highno/wordclock_mini/docs/wordclock mini_breadboard.png

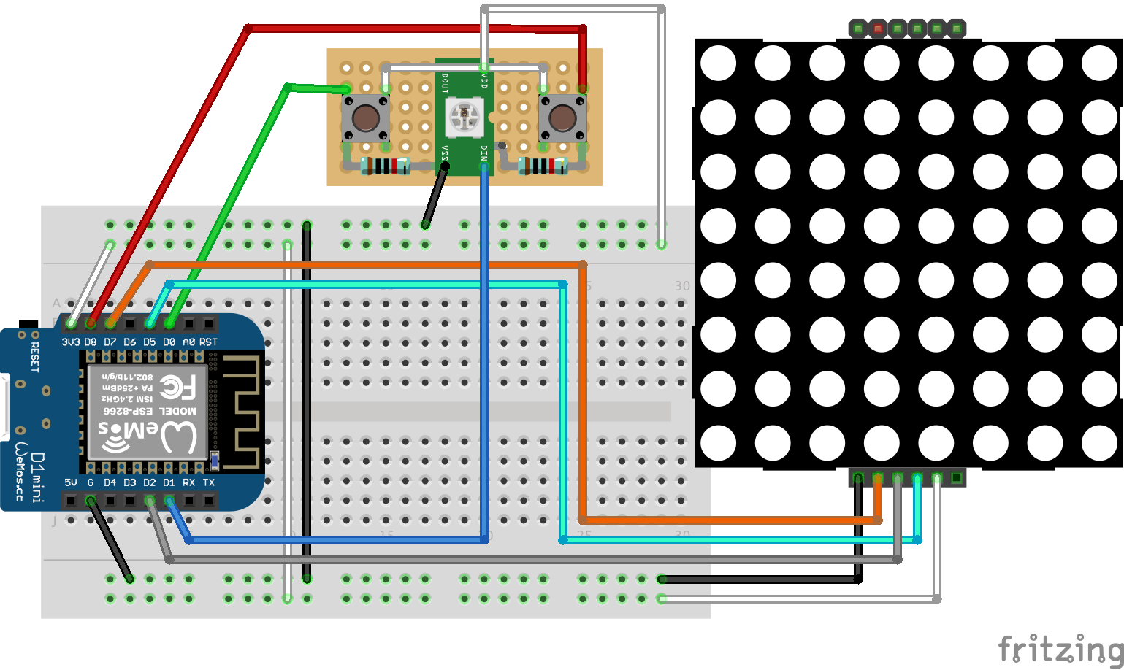
docs/wordclock mini_breadboard.png
