highno/wordclock_mini/docs/wordclock mini_schematics.png

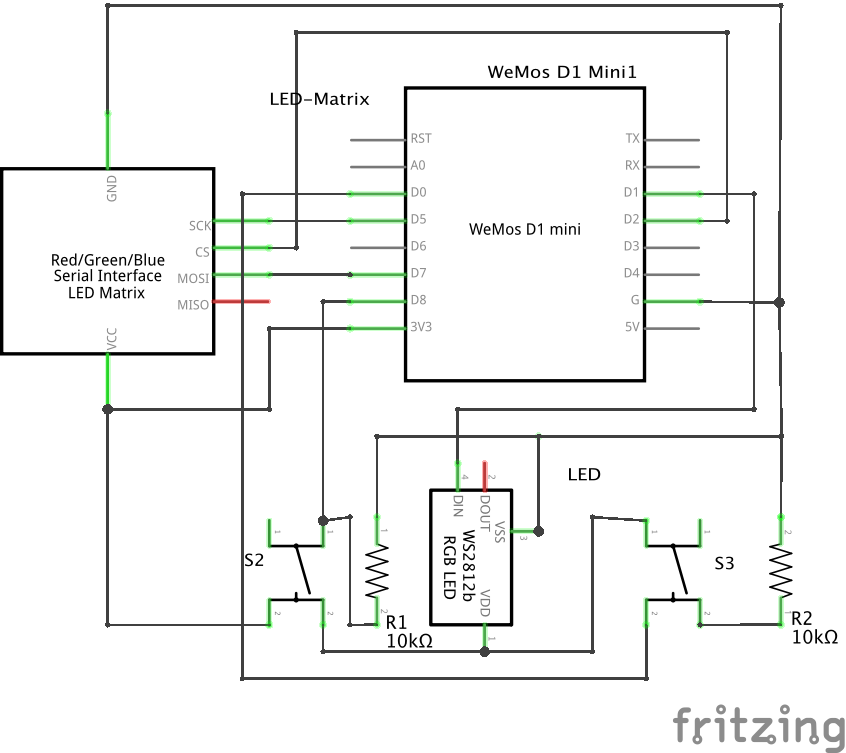
docs/wordclock mini_schematics.png
