highno/wordclock_mini/include/cp437font.h

#include <Arduino.h>
// bit patterns for the CP437 font

const byte cp437_fontsize [] PROGMEM = {
  0x08,
  0x08,
  0x08,
  0x07,
  0x07,
  0x07,
  0x07,
  0x24,
  0x08,
  0x16,
 
  0x08,
  0x08,
  0x16,
  0x08,
  0x08,
  0x08,
  0x07,
  0x07,
  0x16,
  0x16,
  
  0x08,
  0x08,
  0x16,
  0x08,
  0x16,
  0x16,
  0x07,
  0x07,
  0x07,
  0x08,
  
  0x08,
  0x08,
  0x05,
  0x14,
  0x23,
  0x07,
  0x06,
  0x07,
  0x07,
  0x03,
  
  0x14,
  0x14,
  0x08,
  0x06,
  0x13,
  0x04,
  0x22,
  0x07,
  0x07,
  0x06,
  
  0x06,
  0x06,
  0x07,
  0x06,
  0x06,
  0x06,
  0x06,
  0x06,
  0x22,
  0x13,
  
  0x05,
  0x04,
  0x15,
  0x06,
  0x07,
  0x16, // A
  0x16,
  0x16,
  0x16,
  0x16,

  0x16, // F
  0x16,
  0x16,
  0x24,
  0x16,
  0x16,
  0x16, // L
  0x17,
  0x17,
  0x16,
  
  0x16,
  0x16, // Q
  0x16,
  0x16,
  0x16,
  0x16, // U
  0x16,
  0x17,
  0x17,
  0x16,
  
  0x16, // Z
  0x14,
  0x07,
  0x14,
  0x07,
  0x05,
  0x23,
  0x16, // a
  0x16,
  0x16,
  
  0x16,
  0x16, // e
  0x16,
  0x16,
  0x16,
  0x32,
  0x15, // j
  0x16,
  0x33,
  
  0x17,
  0x16,
  0x16, // o
  0x16,
  0x16,
  0x16,
  0x16,
  0x25, // t
  0x16,
  0x16,
  
  0x17,
  0x16,
  0x16, // y
  0x16,
  
  0x06,
  0x32,
  0x06,
  0x07,
  0x07,
  
  0x06, // 0x80
  0x07,
  0x06,
  0x08,
  0x07,
  
  0x07,
  0x07,
  0x06,
  0x08,
  0x06,
  
  0x06,
  0x06,
  0x07,
  0x05,
  0x07,
  
  0x06, // 0x8f
  0x06,
  0x08,
  0x07,
  0x06,
  
  0x06,
  0x06,
  0x07,
  0x07,
  0x06,
  
  0x08,
  0x06,
  0x07,
  0x07,
  0x06,
  
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
  { 0x40, 0xC0, 0x88, 0xFE, 0x7F, 0x09, 0x03, 0x02 }, // 0x9F
  { 0x20, 0x74, 0x54, 0x55, 0x7D, 0x79, 0x40, 0x00 }, // 0xA0
  { 0x00, 0x44, 0x7D, 0x7D, 0x41, 0x00, 0x00, 0x00 }, // 0xA1
  { 0x30, 0x78, 0x48, 0x4A, 0x7A, 0x32, 0x00, 0x00 }, // 0xA2
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
};
