highno/wordclock_mini/src/LedMatrix.cpp

#include <SPI.h>
#include "LedMatrix.h"
#include "cp437font.h"
#define DEBUG 1
#include "debug.h"

/**
 * Heavily influenced by the code and the blog posts from https://github.com/nickgammon/MAX7219_Dot_Matrix
 */
LedMatrix::LedMatrix(byte numberOfDevices, byte slaveSelectPin) {
    myNumberOfDevices = numberOfDevices;
    mySlaveSelectPin = slaveSelectPin;
    cols = new byte[numberOfDevices * 8];
}

/**
 *  numberOfDevices: how many modules are daisy changed togehter
 *  slaveSelectPin: which pin is controlling the CS/SS pin of the first module?
 */
void LedMatrix::init() {
    pinMode(mySlaveSelectPin, OUTPUT);
    
    SPI.begin ();
    SPI.setDataMode(SPI_MODE0);
    SPI.setClockDivider(SPI_CLOCK_DIV128);
    for(byte device = 0; device < myNumberOfDevices; device++) {
        sendByte (device, MAX7219_REG_SCANLIMIT, 7);   // show all 8 digits
        sendByte (device, MAX7219_REG_DECODEMODE, 0);  // using an led matrix (not digits)
        sendByte (device, MAX7219_REG_DISPLAYTEST, 0); // no display test
        sendByte (device, MAX7219_REG_INTENSITY, 0);   // character intensity: range: 0 to 15
        sendByte (device, MAX7219_REG_SHUTDOWN, 1);    // not in shutdown mode (ie. start it up)
    }
    muted = false;
}

void LedMatrix::sendByte (const byte device, const byte reg, const byte data) {
    int offset=device;
    int maxbytes=myNumberOfDevices;
    
    for(int i=0;i<maxbytes;i++) {
        spidata[i] = (byte)0;
        spiregister[i] = (byte)0;
    }
    // put our device data into the array
    spiregister[offset] = reg;
    spidata[offset] = data;
    // enable the line
    digitalWrite(mySlaveSelectPin,LOW);
    // now shift out the data
    for(int i=0;i<myNumberOfDevices;i++) {
        SPI.transfer (spiregister[i]);
        SPI.transfer (spidata[i]);
    }
    digitalWrite (mySlaveSelectPin, HIGH);
    
}

void LedMatrix::sendByte (const byte reg, const byte data) {
    for(byte device = 0; device < myNumberOfDevices; device++) {
        sendByte(device, reg, data);
    }
}

void LedMatrix::setIntensity(const byte intensity) {
    sendByte(MAX7219_REG_INTENSITY, intensity);
}

void LedMatrix::setCharWidth(byte charWidth) {
    myCharWidth = charWidth;
}

void LedMatrix::setTextAlignment(byte textAlignment) {
    myTextAlignment = textAlignment;
    calculateTextAlignmentOffset();
}

void LedMatrix::calculateTextAlignmentOffset() {
    switch(myTextAlignment) {
        case TEXT_ALIGN_LEFT:
            myTextAlignmentOffset = 0;
            break;
        case TEXT_ALIGN_LEFT_END:
            myTextAlignmentOffset = myNumberOfDevices * 8;
            break;
        case TEXT_ALIGN_RIGHT:
            myTextAlignmentOffset = myText.length() * myCharWidth - myNumberOfDevices * 8;
            break;
        case TEXT_ALIGN_RIGHT_END:
            myTextAlignmentOffset = - myText.length() * myCharWidth;
            break;
    }
    
}

int LedMatrix::textLengthProportional(String text) {
  int l = 0;
  for (int i = 0; i<text.length(); i++) {
    l += (pgm_read_byte (&cp437_fontsize[text.charAt(i) & 0xff]) & 0xf) + 1;
    if (text.charAt(i)>255) {
      DPRINT ("Printing non ASCII char: "); DPRINTLN(text.charAt(i));
    }
  }
  return l;
}

void LedMatrix::calculateTextAlignmentOffsetProportional() {
    switch(myTextAlignment) {
        case TEXT_ALIGN_LEFT:
            myTextAlignmentOffset = 0;
            break;
        case TEXT_ALIGN_LEFT_END:
            myTextAlignmentOffset = myNumberOfDevices * 8;
            break;
        case TEXT_ALIGN_RIGHT:
            myTextAlignmentOffset = textLengthProportional(myText) - myNumberOfDevices * 8;
            break;
        case TEXT_ALIGN_RIGHT_END:
            myTextAlignmentOffset = - textLengthProportional(myText);
            break;
    }
    
}

void LedMatrix::clear() {
    for (byte col = 0; col < myNumberOfDevices * 8; col++) {
        cols[col] = 0;
    }
    
}

void LedMatrix::commit() {
  if (!muted) {
    for (byte col = 0; col < myNumberOfDevices * 8; col++) {
        sendByte(col / 8, col % 8 + 1, cols[col]);
    }
  }
}

void LedMatrix::mute() {
    muted = true;
    for (byte col = 0; col < myNumberOfDevices * 8; col++) {
        sendByte(col / 8, col % 8 + 1, 0);
    }
}

void LedMatrix::unmute() {
    muted = false;
    commit();
}

void LedMatrix::setText(String text) {
    myText = text;
    myTextOffset = 0;
    calculateTextAlignmentOffset();
    doneScrolling = false;
}

bool LedMatrix::isScrollingDone() {
  return doneScrolling;
}

void LedMatrix::setTextProportional(String text) {
    myText = text;
    myTextOffset = 0;
    calculateTextAlignmentOffsetProportional();
    doneScrolling = false;
}

void LedMatrix::setNextText(String nextText) {
    myNextText = nextText;
}

void LedMatrix::scrollTextRightProportional() {
    myTextOffset = (myTextOffset + 1) % (textLengthProportional(myText));
}

void LedMatrix::scrollTextRight() {
    myTextOffset = (myTextOffset + 1) % ((int)myText.length() * myCharWidth - 5);
}

void LedMatrix::scrollTextLeftProportional() {
    myTextOffset = (myTextOffset - 1) % (textLengthProportional(myText) + myNumberOfDevices * 8);
    if (myTextOffset == 0) {
      if (myNextText.length() > 0) {
        myText = myNextText;
        myNextText = "";
        calculateTextAlignmentOffsetProportional();
      } else {
        doneScrolling = true;
      }
    }
}

void LedMatrix::scrollTextLeft() {
    myTextOffset = (myTextOffset - 1) % ((int)myText.length() * myCharWidth + myNumberOfDevices * 8);
    if (myTextOffset == 0) {
      if (myNextText.length() > 0) {
        myText = myNextText;
        myNextText = "";
        calculateTextAlignmentOffset();
      } else {
        doneScrolling = true;
      }
    }
}

void LedMatrix::oscillateTextProportional() {
    int maxColumns = (int)textLengthProportional(myText);
    int maxDisplayColumns = myNumberOfDevices * 8;
    if (maxDisplayColumns > maxColumns) {
        return;
    }
    if (myTextOffset - maxDisplayColumns == -maxColumns) {
        increment = 1;
    }
    if (myTextOffset == 0) {
        increment = -1;
    }
    myTextOffset += increment;
}

void LedMatrix::oscillateText() {
    int maxColumns = (int)myText.length() * myCharWidth;
    int maxDisplayColumns = myNumberOfDevices * 8;
    if (maxDisplayColumns > maxColumns) {
        return;
    }
    if (myTextOffset - maxDisplayColumns == -maxColumns) {
        increment = 1;
    }
    if (myTextOffset == 0) {
        increment = -1;
    }
    myTextOffset += increment;
}

void LedMatrix::drawTextProportional() {
    byte len = 0;
    byte val = 0;
    byte start_pos = 0;
    char letter;
    int position = 0;
    int active_position = 0;
    for (int i = 0; i < myText.length(); i++) {
        letter = myText.charAt(i);
        val = pgm_read_byte (&cp437_fontsize[letter]);
        start_pos = val; start_pos = start_pos >> 4;
        len = val & 0xf;
 /*       if (letter == 'i') {
          DPRINTLN("");
          DPRINT(" soll 'i' berechnen - start_pos = "); DPRINT(start_pos);
          DPRINT("; len = "); DPRINT(len);
          DPRINT("; active_position = "); DPRINTLN(active_position);
        } */
        for (byte col = start_pos; col < start_pos+len+1; col++) {
            position = active_position + col - start_pos + myTextOffset + myTextAlignmentOffset;
/*            DPRINT("position = "); DPRINT(position);
            DPRINT("; col = "); DPRINT(col);
            DPRINT("; len = "); DPRINT(len);
            DPRINT("; start_pos = "); DPRINT(start_pos); */
            if (position >= 0 && position < myNumberOfDevices * 8) {
                if (col == start_pos+len) {
                  setColumn(position, 0); // trailing spacer after each character
//                  DPRINTLN(" - Ende des Chars, Leerspalte");
                } else {
                  setColumn(position, pgm_read_byte (&cp437_font [letter] [col]));
//                  DPRINTLN(" - Spalte eingefügt");
                }
            } else {
//              DPRINTLN("");
            }
        }
        active_position += len + 1;
    }
}

void LedMatrix::drawText() {
    char letter;
    int position = 0;
    for (int i = 0; i < myText.length(); i++) {
        letter = myText.charAt(i);
        for (byte col = 0; col < 8; col++) {
            position = i * myCharWidth + col + myTextOffset + myTextAlignmentOffset;
            if (position >= 0 && position < myNumberOfDevices * 8) {
                setColumn(position, pgm_read_byte (&cp437_font [letter] [col]));
            }
        }
    }
}

void LedMatrix::setColumn(int column, byte value) {
    if (column < 0 || column >= myNumberOfDevices * 8) {
        return;
    }
    cols[column] = value;
}

void LedMatrix::setPixel(byte x, byte y) {
    bitWrite(cols[x], y, true);
}
