highno/wordclock_mini/(commit log)

2019-04-02 using ace_button lib and configurable button functions; code cleanup
2019-04-12 added schematics and breadboard setup
2020-02-01 Added links to 3D print files
2020-12-28 Bauanleitung und Buchstabenmatrix ergänzt
    build instructions added (contains german character matrix)
2020-12-28 fixed fading where fader possibly got negative
    [main.cpp]
2020-12-29 slight changes to config management fix for #7
    [main.cpp]
2020-12-30 fixed cold boot problem with led matrix inserted button lib and event handler stub
    [main.cpp]
2020-12-30 inserted button lib and event handler stub
2020-12-30 added MQTT messages for buttons messages are maskable via MQTT
2020-12-31 button function setting via MQTT
